gitHipL/009_RGB-Sound-Control-Light-Bar-Redesign_fraseross/009_RGB Sound Control Light Bar Redesign_fraseross.kicad_pcb

## KiCad design 009_RGB Sound Control Light Bar Redesign_fraseross.kicad_pcb (2025-05-21)

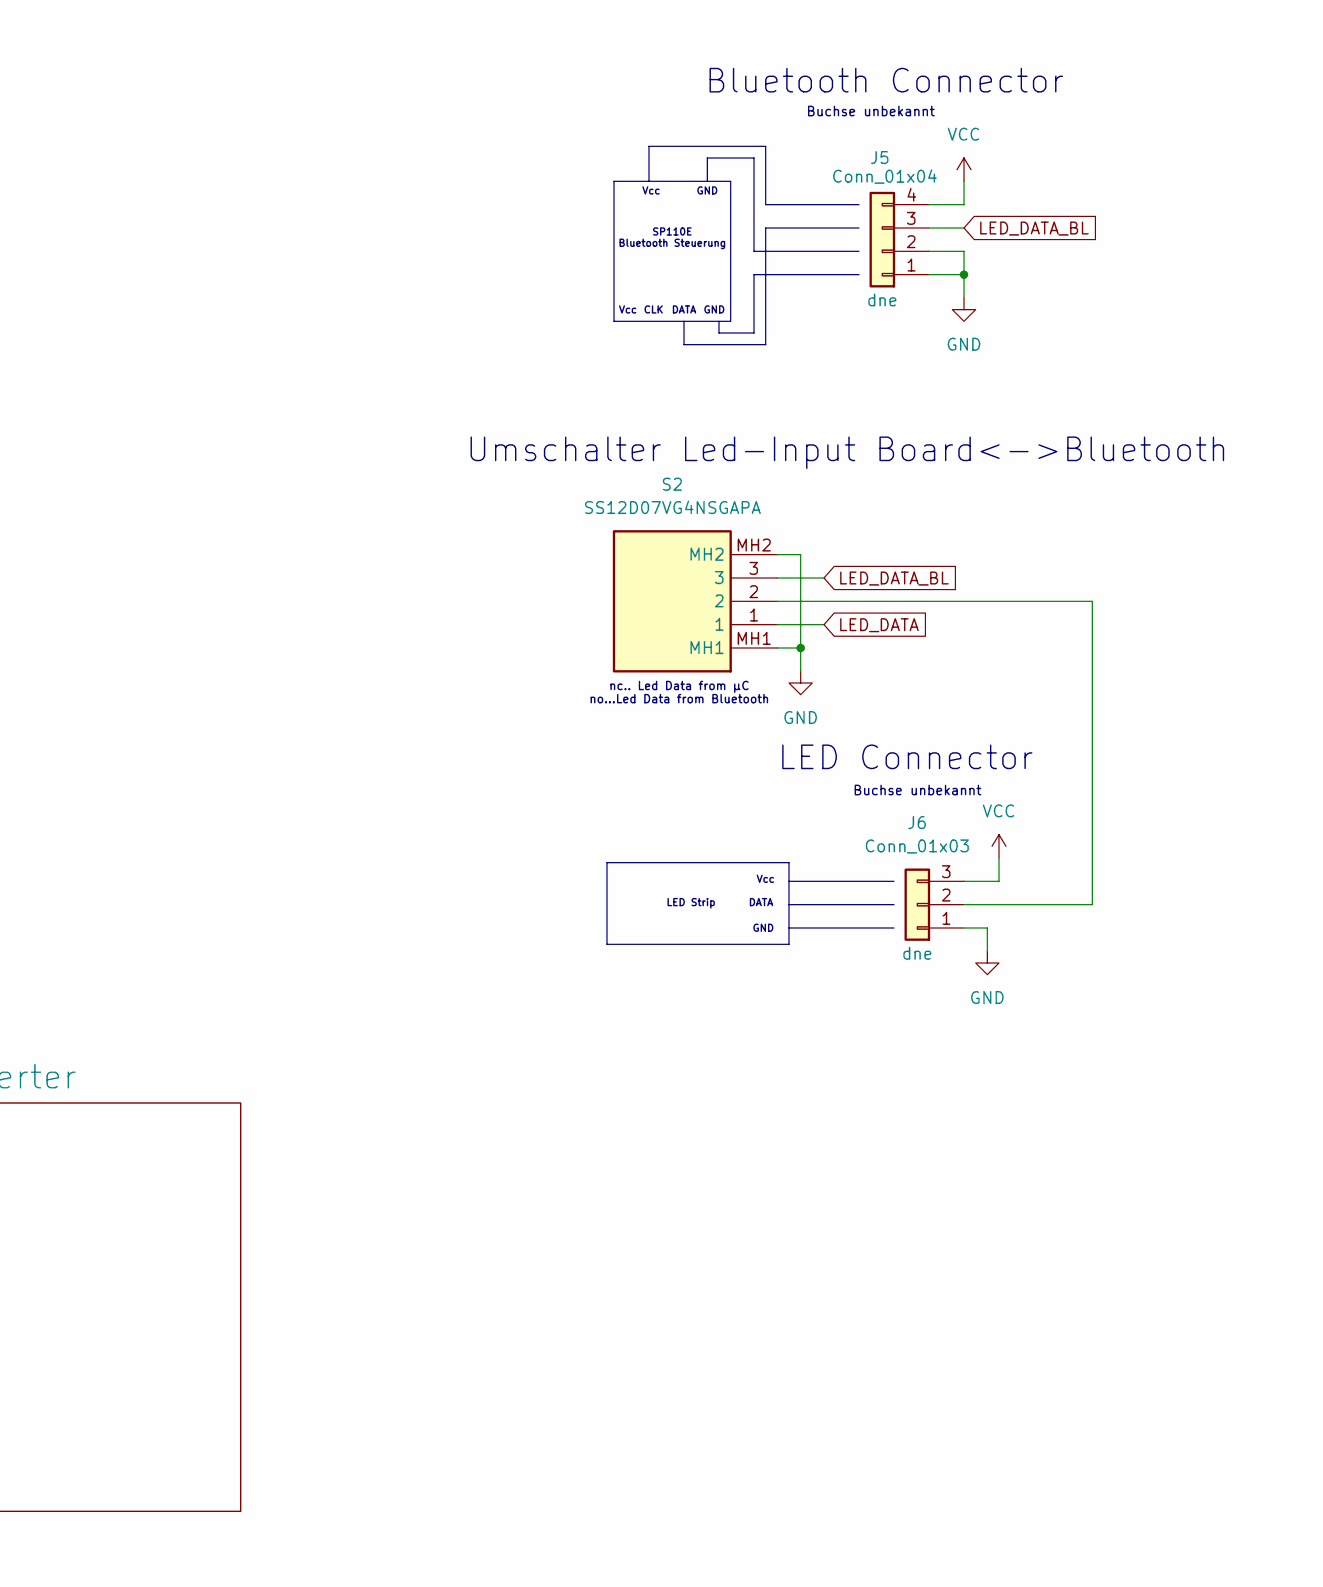
[picture p1: schematic 009_RGB Sound Control Light Bar Redesign_fraseross.kicad_sch, part in row 1, column 2]

Parts:
J5: Conn_01x04; PinSocket_1x04_P1.00mm_Vertical
J6: Conn_01x03; PinSocket_1x03_P1.00mm_Vertical
S2: SS12D07VG4NSGAPA; Manufacturer_Part_Number SS12D07VG4NSGAPA; Mouser Part Number N/A

Connections:
GND: J5.1, J5.2, J6.1, S2.MH1, S2.MH2; also elsewhere on the board
LED_DATA: S2.1; also elsewhere on the board
LED_DATA_BL: J5.3, S2.3
unnamed: J6.2, S2.2
VCC: J5.4, J6.3; also elsewhere on the board

Notes on the sheet:
Vcc
GND
Buchse unbekannt
LED Connector
Umschalter Led-Input Board<->Bluetooth
nc.. Led Data from µC no...Led Data from Bluetooth
DATA
CLK
Bluetooth Connector
SP110E Bluetooth Steuerung
LED Strip

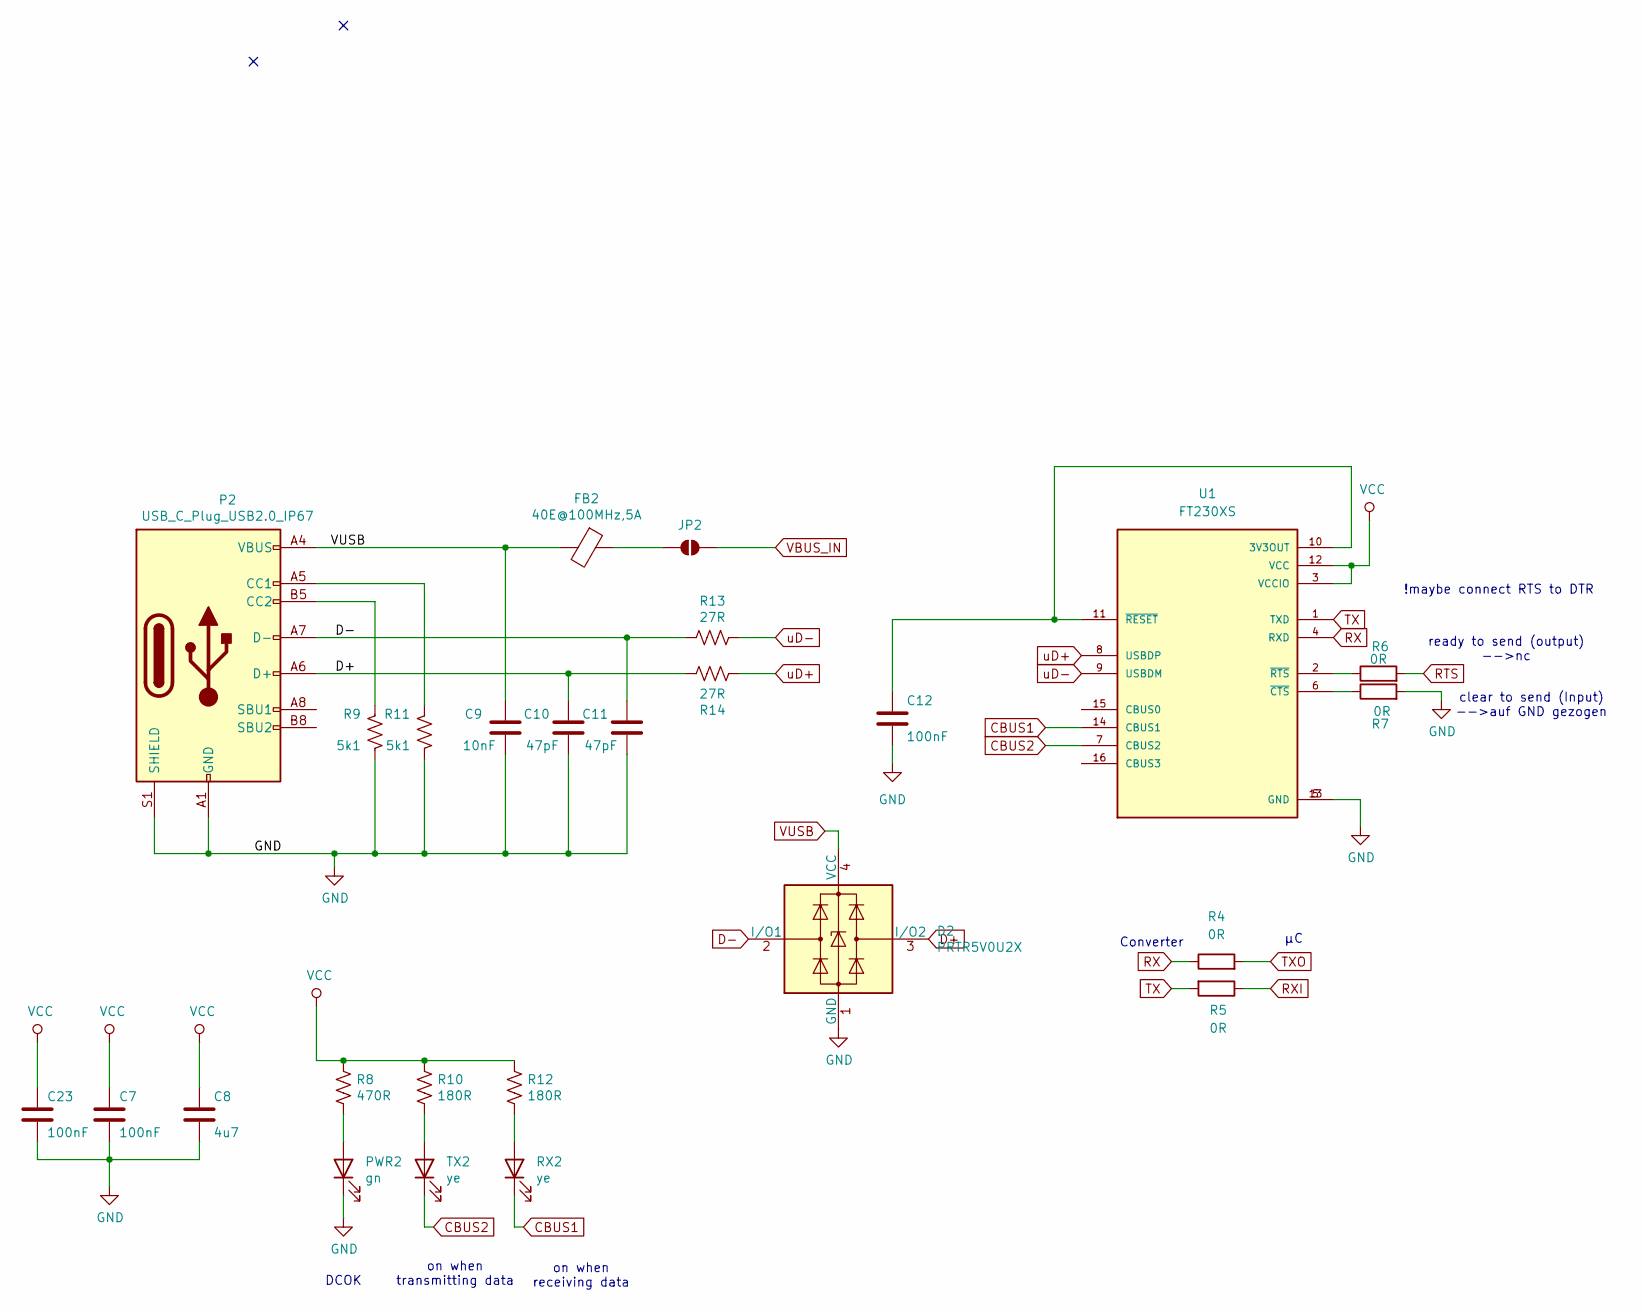
[picture p2: schematic untitled.kicad_sch]

Parts:
C7, C12, C23: 100nF; C_0603_1608Metric; Part C42998
C8: 4u7; C_0805_2012Metric; Part C87998
C9: 10nF; C_0603_1608Metric; Part C100042
C10, C11: 47pF; C_0603_1608Metric; Part C105622
D2: PRTR5V0U2X; SOT-143; LCSC PN C12333
FB2: 40E@100MHz,5A; L_0805_2012Metric; LCSC PN C369522
JP2: SolderJumper_2_Open; SolderJumper-2_P1.3mm_Bridged_RoundedPad1.0x1.5mm
P2: USB_C_Plug_USB2.0_IP67; GCT_USB4730-GF-A_REVA; Part USB4730-GF-A
PWR2: gn; LED_0603_1608Metric; LCSC PN C19171301
R4, R5, R6, R7: 0R; R_0603_1608Metric
R8: 470R; R_0603_1608Metric; LCSC C19171301
R9, R11: 5k1; R_0603_1608Metric; Part C332117
R10, R12: 180R; R_0603_1608Metric; Part C25585
R13, R14: 27R; R_0603_1608Metric; Part C325726
RX2: ye; LED_0603_1608Metric; LCSC PN C965802
TX2: ye; LED_0603_1608Metric; LCSC PN C965802
U1: FT230XS; SSOP-16_3.9x4.9mm_P0.635mm; PARTREV 1.5; LCSC PN C69082

Connections:
CBUS1: RX2.1 (K), U1.14 (CBUS1); also elsewhere on the board
CBUS2: TX2.1 (K), U1.7 (CBUS2); also elsewhere on the board
D+: C10.1, D2.3 (I/O2), P2.A6 (D+), P2.B6 (D+), R14.2
D-: C11.1, D2.2 (I/O1), P2.A7 (D-), P2.B7 (D-), R13.1
GND: C7.2, C8.2, C9.2, C10.2, C11.2, C12.2, C23.2, D2.1 (GND), P2.A1 (GND), P2.S1 (SHIELD), PWR2.1 (K), R7.2, R9.2, R11.2, U1.5 (GND), U1.13 (GND); also elsewhere on the board
unnamed: FB2.1, JP2.1 (A)
unnamed: P2.A5 (CC1), R11.1
unnamed: P2.B5 (CC2), R9.1
unnamed 32: PWR2.2 (A), R8.2; also elsewhere on the board
unnamed 33: R12.2, RX2.2 (A); also elsewhere on the board
unnamed 35: R10.2, TX2.2 (A); also elsewhere on the board
unnamed: C12.1, U1.10 (3V3OUT), U1.11 (~RESET)
unnamed: R7.1, U1.6 (~CTS)
unnamed: R6.1, U1.2 (~RTS)
RTS: R6.2; also elsewhere on the board
RX: R4.1, U1.4 (RXD)
RXI: R5.1; also elsewhere on the board
TX: R5.2, U1.1 (TXD)
TXO: R4.2; also elsewhere on the board
VBUS_IN: JP2.2 (B); also elsewhere on the board
VCC: C7.1, C8.1, C23.1, R8.1, R10.1, R12.1, U1.3 (VCCIO), U1.12 (VCC); also elsewhere on the board
VUSB: C9.1, D2.4 (VCC), FB2.2, P2.A4 (VBUS)
uD+: R14.1, U1.8 (USBDP)
uD-: R13.2, U1.9 (USBDM)

Notes on the sheet:
on when receiving data
DCOK
ready to send (output) -->nc
on when transmitting data
Converter
clear to send (Input) -->auf GND gezogen
!maybe connect RTS to DTR

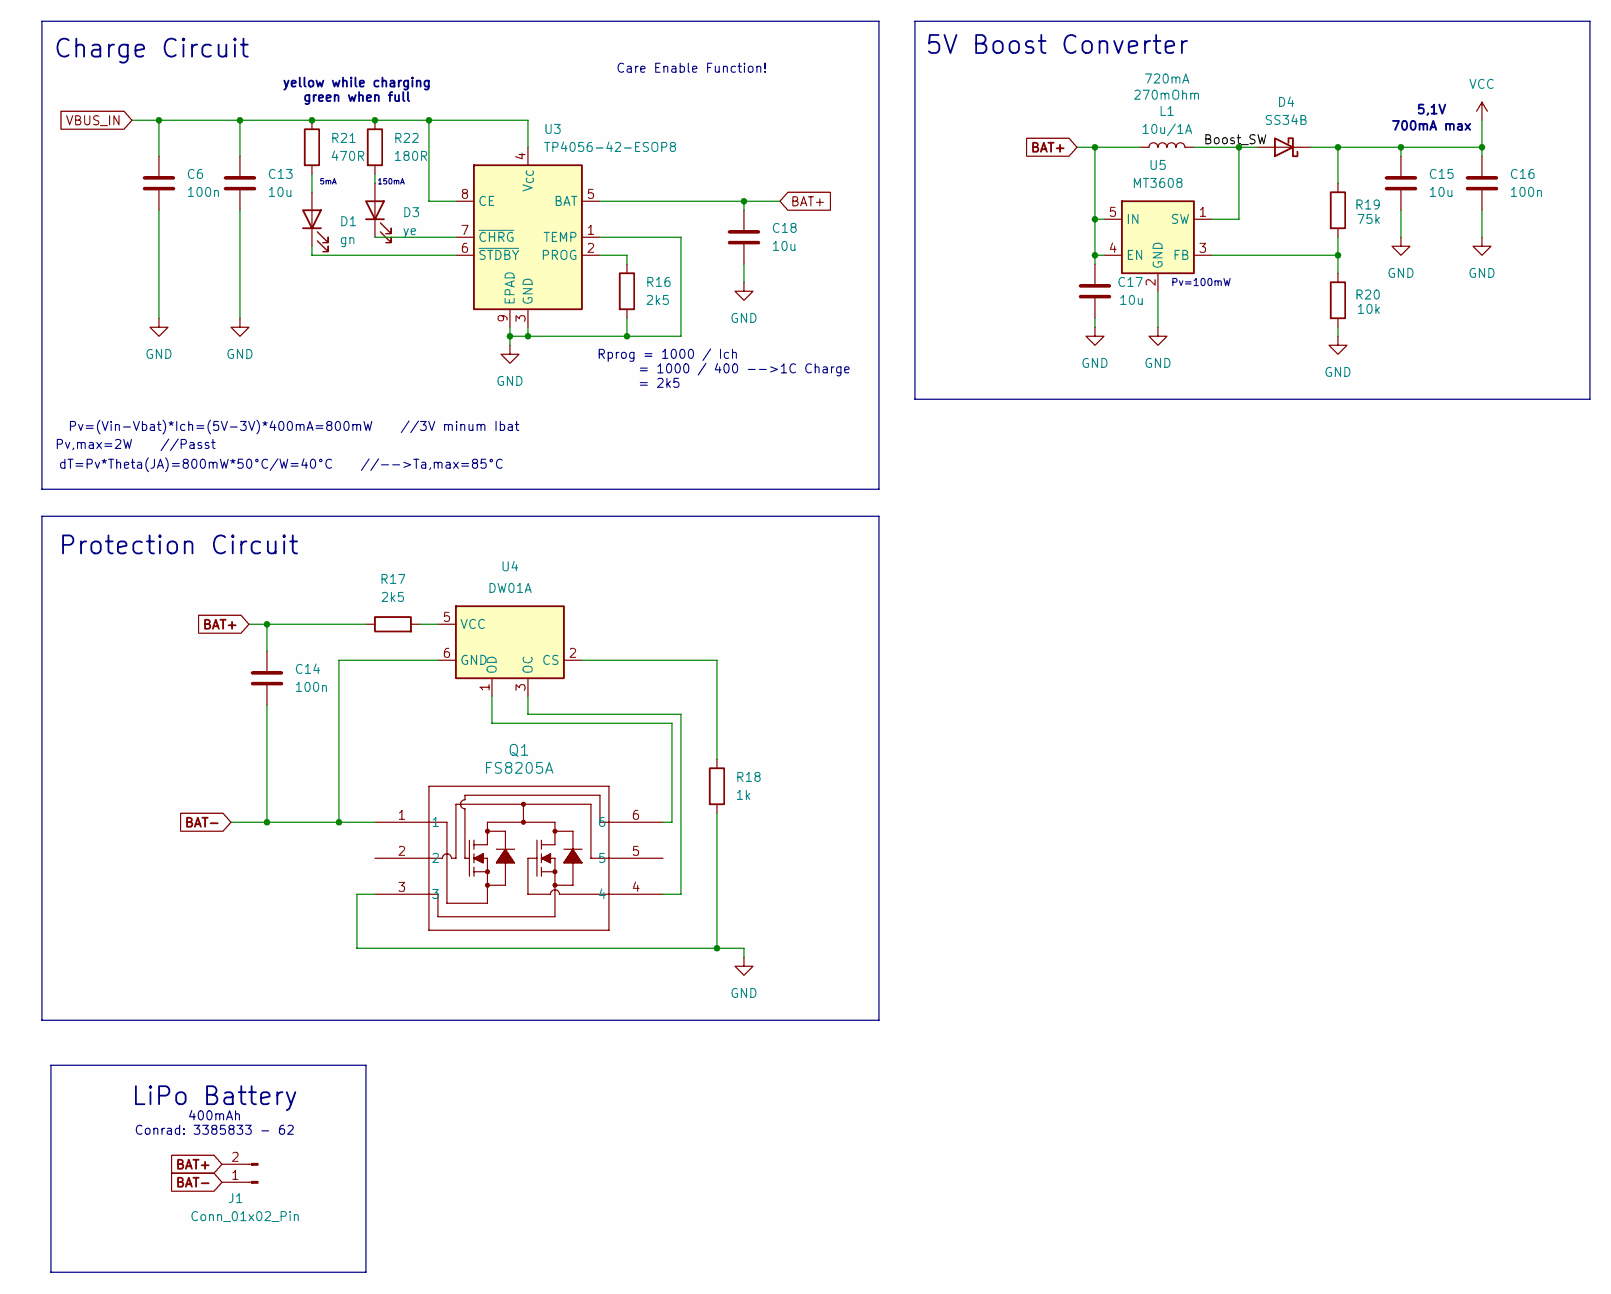
[picture p3: schematic Protection & Charge Circuit + LiPo.kicad_sch]

Parts:
C6, C14, C16: 100n; C_0603_1608Metric
C13, C18: 10u; C_0603_1608Metric
C15, C17: 10u; C_0805_2012Metric
D1: gn; LED_0603_1608Metric; LCSC PN C19171301
D3: ye; LED_0603_1608Metric; LCSC PN C965802
D4: SS34B; D_SMB; LCSC PN C13762
J1: Conn_01x02_Pin; PinHeader_1x02_P2.54mm_Vertical
L1: 10u/1A; L_Coilcraft_LPS3010; LCSC C280522
Q1: FS8205A; SOT-23-6; LCSC PN C2830320
R16: 2k5; R_0603_1608Metric
R17: 2k5; R_0805_2012Metric
R18: 1k; R_0603_1608Metric
R19: 75k; R_0603_1608Metric
R20: 10k; R_0603_1608Metric
R21: 470R; R_0603_1608Metric
R22: 180R; R_0603_1608Metric
U3: TP4056-42-ESOP8; SOIC-8-1EP_3.9x4.9mm_P1.27mm_EP2.41x3.3mm_ThermalVias; LCSC PN C725790
U4: DW01A; SOT-23-6; LCSC PN C2927799
U5: MT3608; SOT-23-6; LCSC PN C84817

Connections:
/Power/Boost_SW: D4.2 (A), L1.2, U5.1 (SW)
BAT+: C14.2, C17.1, C18.2, J1.2, L1.1, R17.1, U3.5 (BAT), U5.4 (EN), U5.5 (IN)
BAT-: C14.1, J1.1, Q1.1, U4.6 (GND)
GND: C6.1, C13.1, C15.2, C16.2, C17.2, C18.1, Q1.3, R16.2, R18.2, R20.2, U3.1 (TEMP), U3.3 (GND), U3.9 (EPAD), U5.2 (GND); also elsewhere on the board
unnamed: D1.2 (A), R21.2
unnamed: D1.1 (K), U3.6 (~STDBY)
unnamed: D3.2 (A), R22.2
unnamed: D3.1 (K), U3.7 (~CHRG)
unnamed: R16.1, U3.2 (PROG)
unnamed: R18.1, U4.2 (CS)
unnamed: Q1.4, U4.3 (OC)
unnamed: Q1.6, U4.1 (OD)
unnamed: R17.2, U4.5 (VCC)
unnamed: R19.2, R20.1, U5.3 (FB)
VBUS_IN: C6.2, C13.2, R21.1, R22.1, U3.4 (V_{CC}), U3.8 (CE); also elsewhere on the board
VCC: C15.1, C16.1, D4.1 (K), R19.1; also elsewhere on the board

Notes on the sheet:
400mAh Conrad: 3385833 - 62
LiPo Battery
dT=Pv*Theta(JA)=800mW*50°C/W=40°C //-->Ta,max=85°C
yellow while charging green when full
Rprog = 1000 / Ich = 1000 / 400 -->1C Charge = 2k5
5mA
5V Boost Converter
150mA
Pv=100mW
5,1V
700mA max
Protection Circuit
Care Enable Function!
Pv,max=2W //Passt
Charge Circuit
Pv=(Vin-Vbat)*Ich=(5V-3V)*400mA=800mW //3V minum Ibat

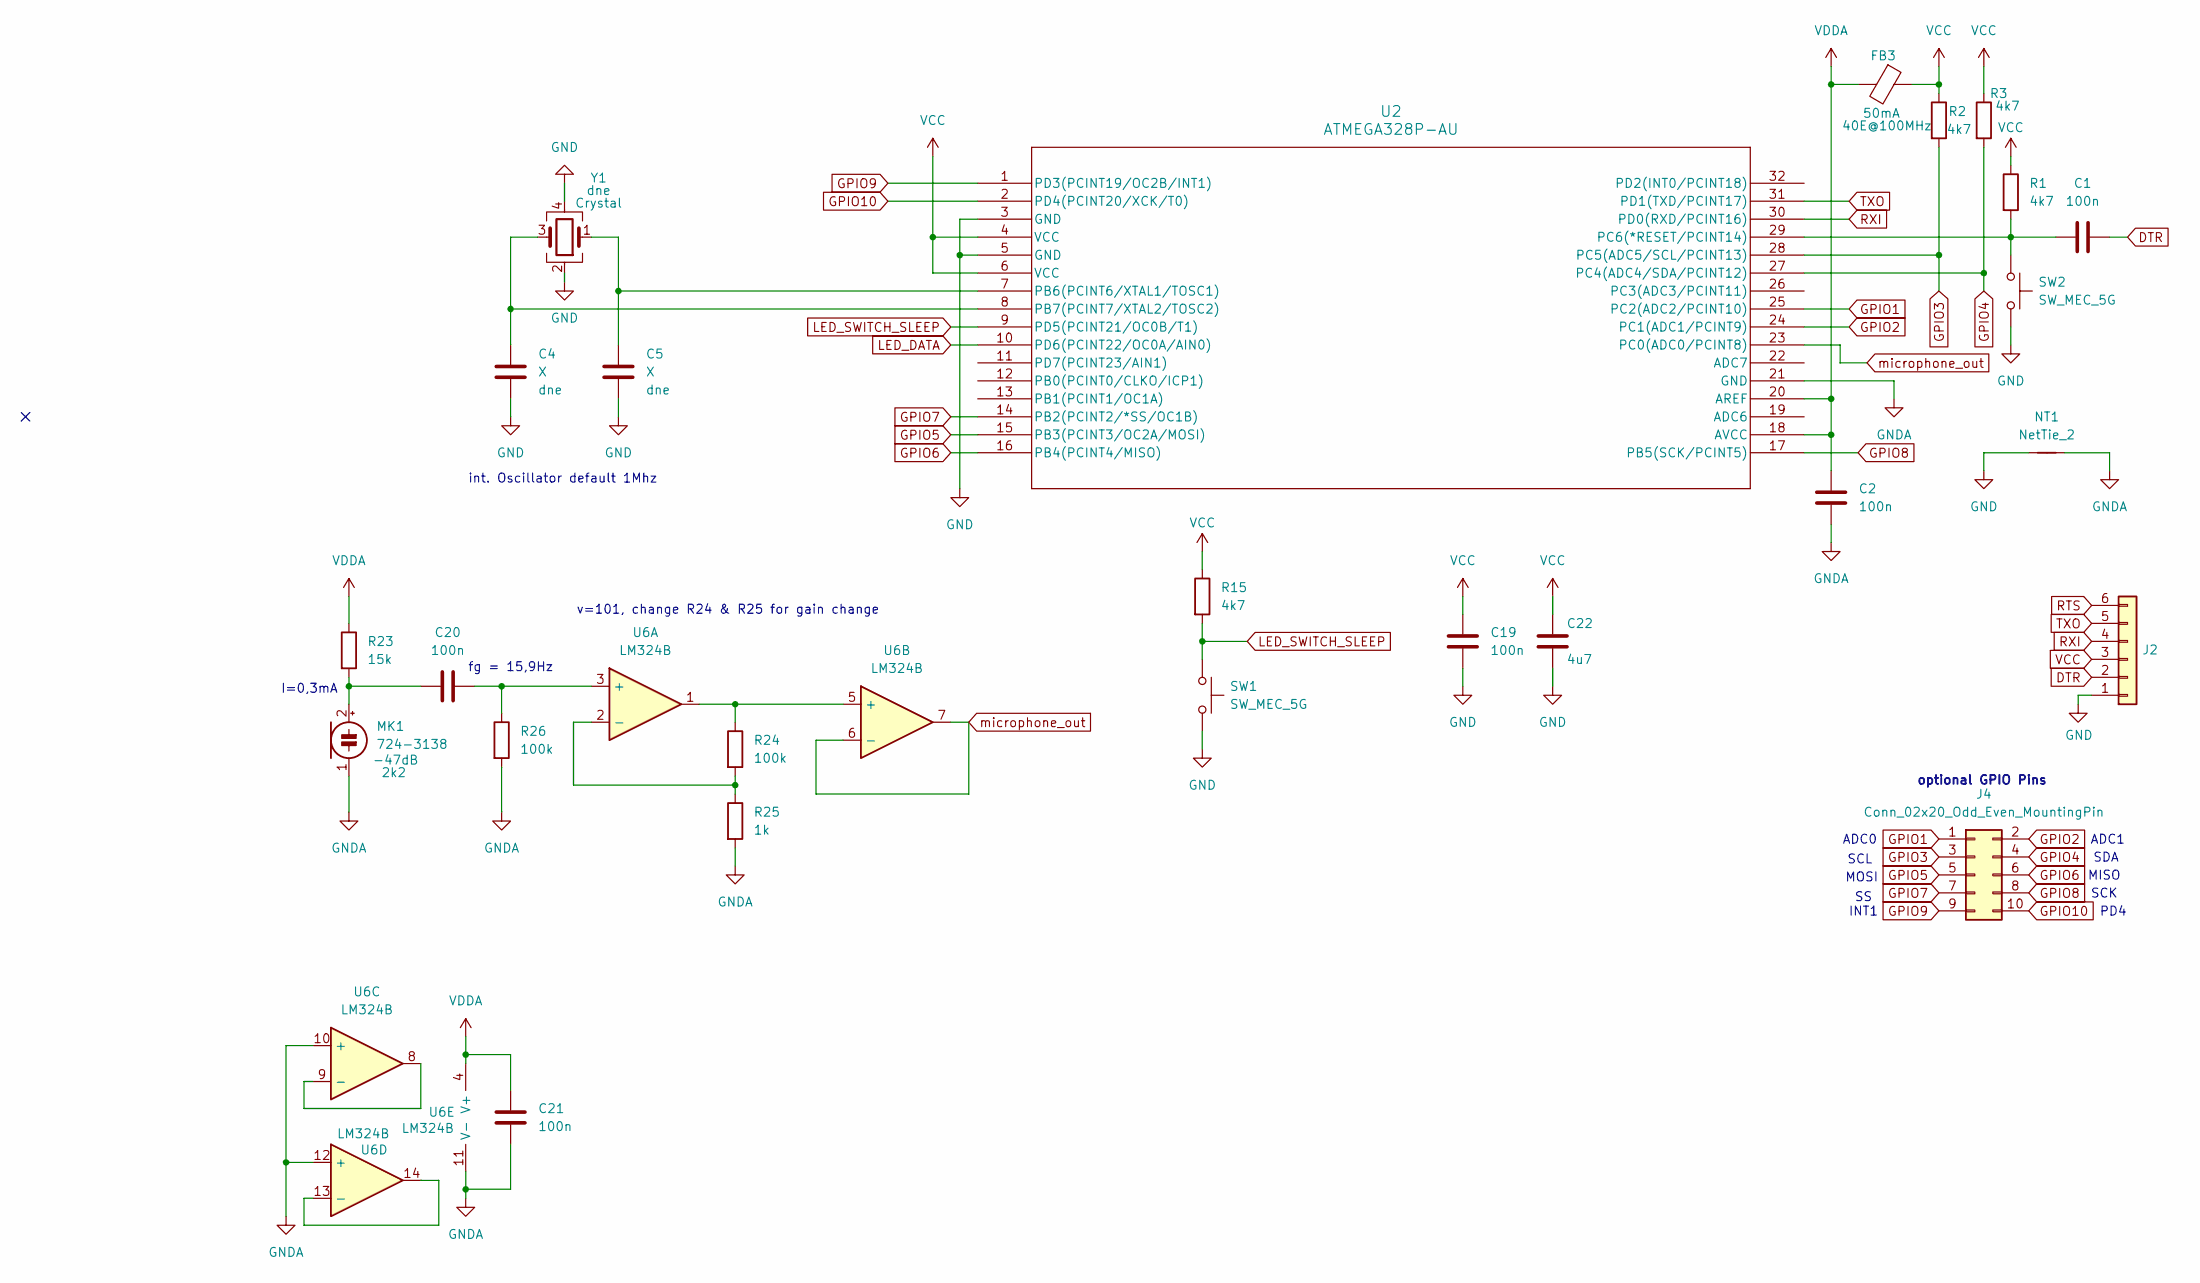
[picture p4: schematic µC.kicad_sch]

Parts:
C1, C2, C19, C20, C21: 100n; C_0603_1608Metric
C4, C5: X; C_0603_1608Metric
C22: 4u7; C_0805_2012Metric; Part C87998
FB3: 40E@100MHz; L_0603_1608Metric; LCSC PN C142073
J2: Conn_01x06; PinHeader_1x06_P2.54mm_Vertical
J4: Conn_02x20_Odd_Even_MountingPin; PinHeader_2x05_P1.00mm_Vertical_SMD
MK1: 724-3138; 724-3138 microphone RS Components
NT1: NetTie_2; NetTie-2_SMD_Pad0.5mm
R1, R2, R3, R15: 4k7; R_0603_1608Metric
R23: 15k; R_0603_1608Metric
R24, R26: 100k; R_0603_1608Metric
R25: 1k; R_0603_1608Metric
SW1: SW_MEC_5G; SW_K2-1112SW-A4SW-04_HRO; LCSC PN C223811
SW2: SW_MEC_5G; SW_Taster_C381039; LCSC C381039
U2: ATMEGA328P-AU; TQFP32_32A_MCH; LCSC PN C14877
U6: LM324B; TSSOP-14_4.4x5mm_P0.65mm; LCSC PN C5214225
Y1: Crystal; Crystal_SMD_Abracon_ABM8AIG-4Pin_3.2x2.5mm; LCSC PN C13738

Connections:
DTR: C1.2, J2.2
GND: C4.1, C5.1, C19.1, C22.2, J2.1, NT1.1, SW1.2 (B), SW2.2 (B), U2.3 (GND), U2.5 (GND), Y1.2, Y1.4; also elsewhere on the board
GNDA: C2.1, C21.1, MK1.1 (-), NT1.2, R25.2, R26.2, U2.21 (GND), U6.10 (+), U6.11 (V-), U6.12 (+)
GPIO1: J4.1, U2.25 (PC2(ADC2/PCINT10))
GPIO2: J4.2, U2.24 (PC1(ADC1/PCINT9))
GPIO3: J4.3, R2.2, U2.28 (PC5(ADC5/SCL/PCINT13))
GPIO4: J4.4, R3.2, U2.27 (PC4(ADC4/SDA/PCINT12))
GPIO5: J4.5, U2.15 (PB3(PCINT3/OC2A/MOSI))
GPIO6: J4.6, U2.16 (PB4(PCINT4/MISO))
GPIO7: J4.7, U2.14 (PB2(PCINT2/*SS/OC1B))
GPIO8: J4.8, U2.17 (PB5(SCK/PCINT5))
GPIO9: J4.9, U2.1 (PD3(PCINT19/OC2B/INT1))
GPIO10: J4.10, U2.2 (PD4(PCINT20/XCK/T0))
LED_DATA: U2.10 (PD6(PCINT22/OC0A/AIN0)); also elsewhere on the board
LED_SWITCH_SLEEP: R15.2, SW1.1 (A), U2.9 (PD5(PCINT21/OC0B/T1))
unnamed: C20.1, MK1.2 (+), R23.2
unnamed: C1.1, R1.2, SW2.1 (A), U2.29 (PC6(*RESET/PCINT14))
unnamed: C5.2, U2.7 (PB6(PCINT6/XTAL1/TOSC1)), Y1.1
unnamed: C4.2, U2.8 (PB7(PCINT7/XTAL2/TOSC2)), Y1.3
unnamed: C20.2, R26.1, U6.3 (+)
unnamed: R24.2, R25.1, U6.2 (-)
unnamed: R24.1, U6.1, U6.5 (+)
unnamed: U6.8, U6.9 (-)
unnamed: U6.13 (-), U6.14
RTS: J2.6; also elsewhere on the board
RXI: J2.4, U2.30 (PD0(RXD/PCINT16)); also elsewhere on the board
TXO: J2.5, U2.31 (PD1(TXD/PCINT17)); also elsewhere on the board
VCC: C19.2, C22.1, FB3.1, J2.3, R1.1, R2.1, R3.1, R15.1, U2.4 (VCC), U2.6 (VCC); also elsewhere on the board
VDDA: C2.2, C21.2, FB3.2, R23.1, U2.18 (AVCC), U2.20 (AREF), U6.4 (V+)
microphone_out: U2.23 (PC0(ADC0/PCINT8)), U6.6 (-), U6.7

Notes on the sheet:
SCL
I=0,3mA
INT1
ADC1
PD4
SDA
optional GPIO Pins
v=101, change R24 & R25 for gain change
MISO
ADC0
int. Oscillator default 1Mhz
fg = 15,9Hz
MOSI
SCK

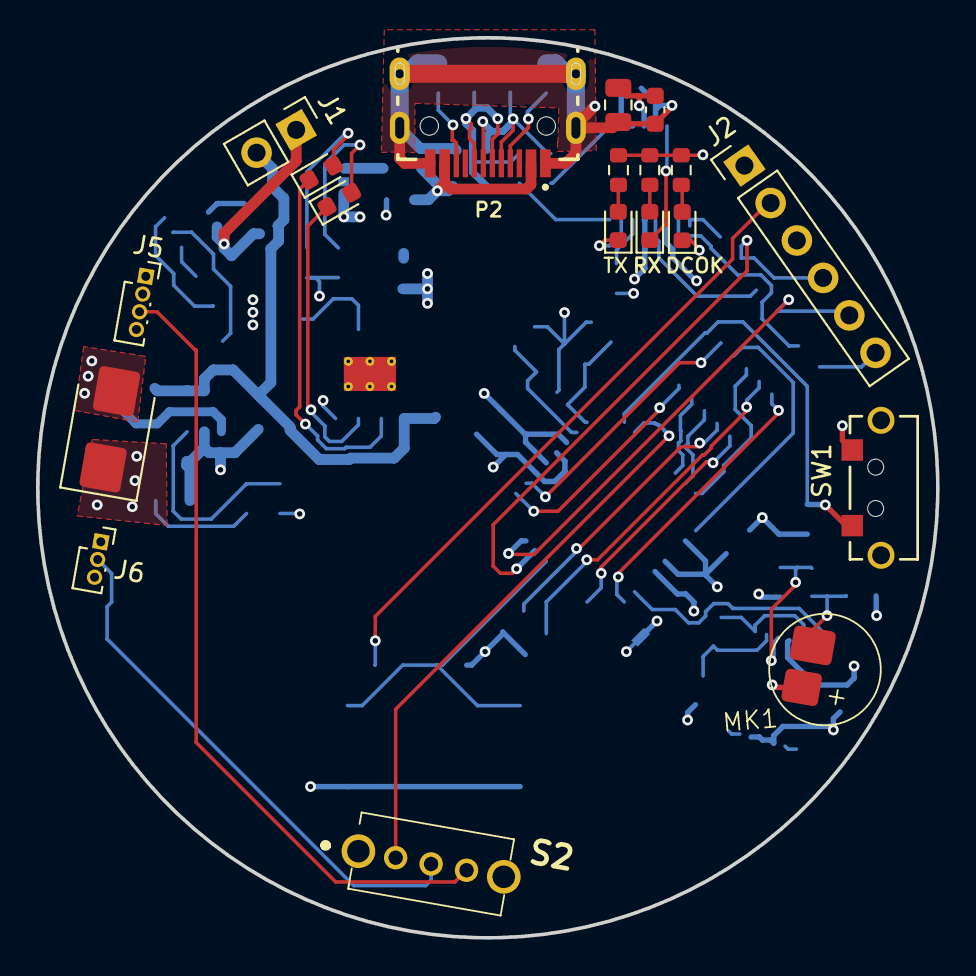
[picture p5: board 009_RGB Sound Control Light Bar Redesign_fraseross.kicad_pcb from above]

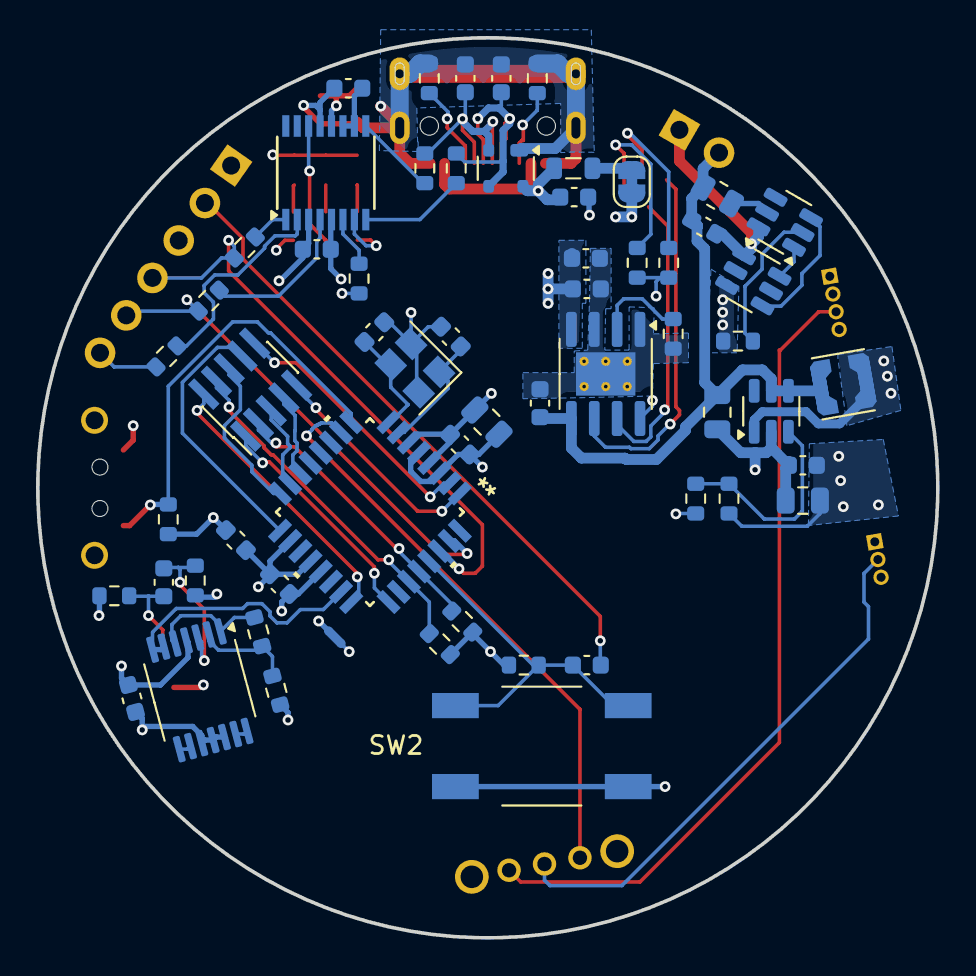
[picture p6: board 009_RGB Sound Control Light Bar Redesign_fraseross.kicad_pcb from below]

Board: 4 copper layers, 50.0 x 50.0 mm, 78 parts (59 on the bottom side), 64 nets.

Other parts of the board:
DCOK: gn; LED_0603_1608Metric
RX: ye; LED_0603_1608Metric
TX: ye; LED_0603_1608Metric

Their connections:
CBUS1: RX.1 (K); also elsewhere on the board
CBUS2: TX.1 (K); also elsewhere on the board
GND: DCOK.1 (K); also elsewhere on the board
unnamed 32: DCOK.2 (A); also elsewhere on the board
unnamed 33: RX.2 (A); also elsewhere on the board
unnamed 35: TX.2 (A); also elsewhere on the board
